e841018/MoDisp/photos/P_20190216_061420_vHDR_Auto.jpg

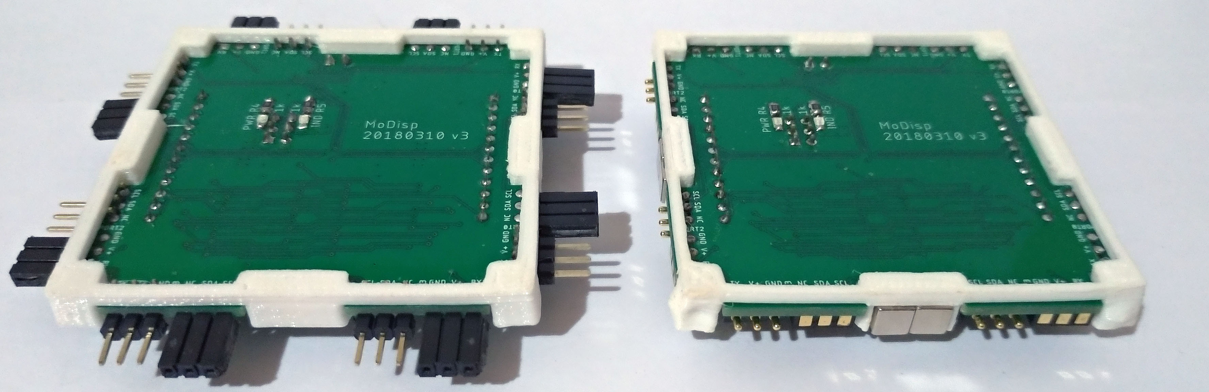
photos/P_20190216_061420_vHDR_Auto.jpg
