e841018/MoDisp/photos/P_20190216_060957_vHDR_Auto.jpg

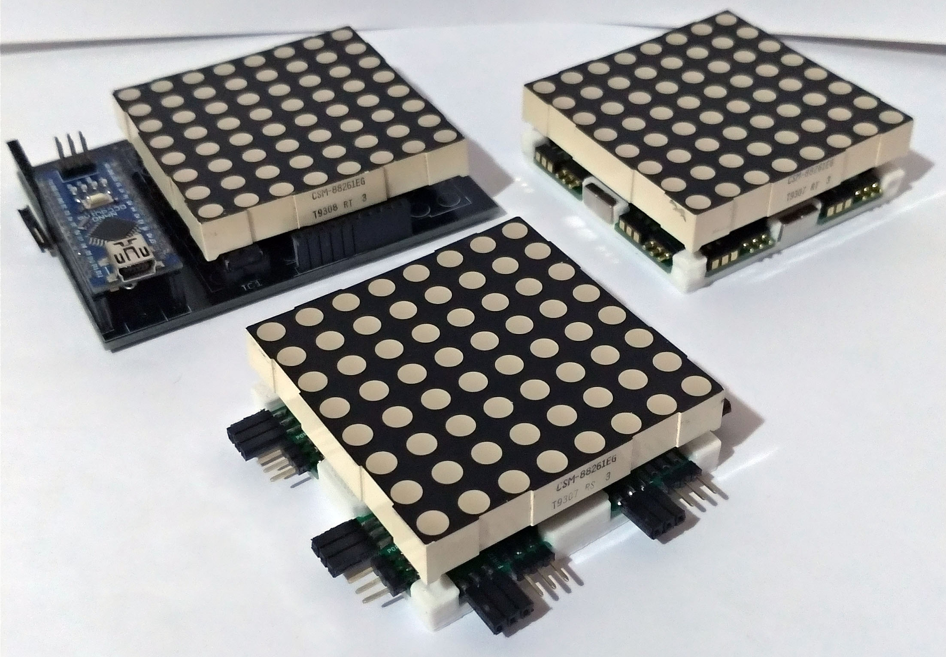
photos/P_20190216_060957_vHDR_Auto.jpg
