e841018/MoDisp/module/PCB/module.brd

## EAGLE design module/PCB/module.brd (2019-04-09)

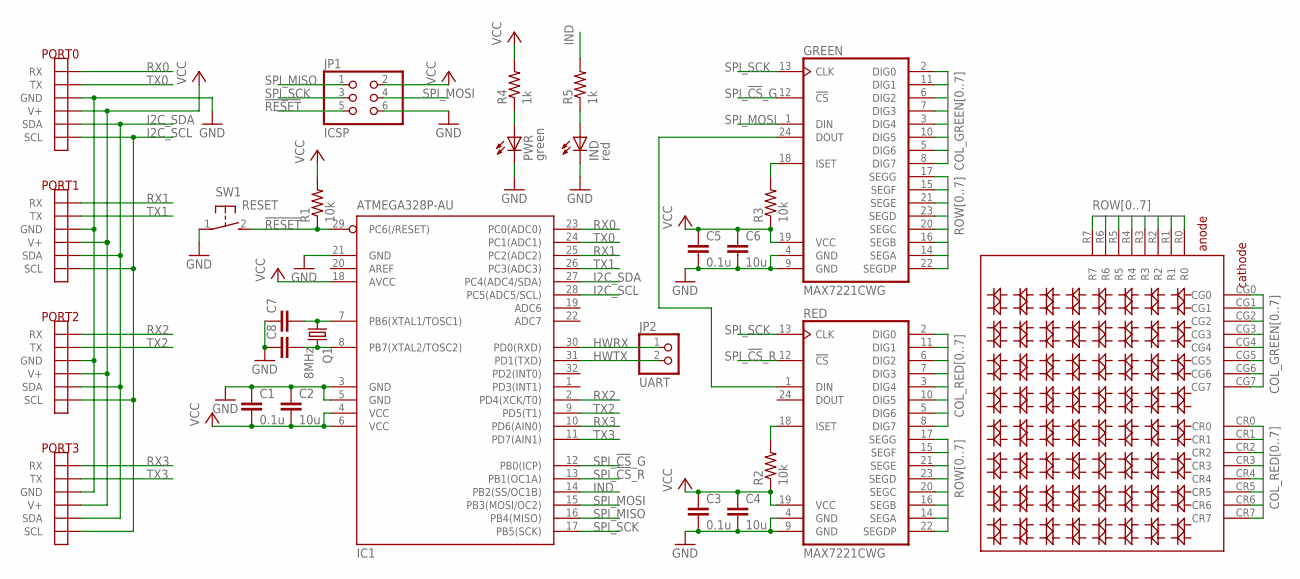
[picture p16: schematic module.sch]

Parts:
C1, C3, C5: 0.1u; C0805
C2, C4, C6: 10u; C1206
C7, C8: C-EUC0805; C0805
GREEN: MAX7221CWG; SO24L
IC1: ATMEGA328P-AU; TQFP32-08
IND: red; CHIPLED_0805
JP1: ICSP; 2X03
JP2: UART; 1X02
PORT0, PORT1, PORT2, PORT3: PORT
PWR: green; CHIPLED_0805
Q1: 8MHz; HC49UP
R1, R2, R3: 10k; R0805
R4, R5: 1k; R0805
RED: MAX7221CWG; SO24L
SW1: RESET; DTSM-3
U$2: 88LED_MATRIX_BICOLOR_ROW_ANODE; 8*8LED_MATRIX_BICOLOR_ROW_ANODE

Connections:
!RESET!: IC1.29 (PC6(/RESET)), JP1.5, R1.1, SW1.2
COL_GREEN0: GREEN.2 (DIG0), U$2.CG0
COL_GREEN1: GREEN.11 (DIG1), U$2.CG1
COL_GREEN2: GREEN.6 (DIG2), U$2.CG2
COL_GREEN3: GREEN.7 (DIG3), U$2.CG3
COL_GREEN4: GREEN.3 (DIG4), U$2.CG4
COL_GREEN5: GREEN.10 (DIG5), U$2.CG5
COL_GREEN6: GREEN.5 (DIG6), U$2.CG6
COL_GREEN7: GREEN.8 (DIG7), U$2.CG7
COL_RED0: RED.2 (DIG0), U$2.CR0
COL_RED1: RED.11 (DIG1), U$2.CR1
COL_RED2: RED.6 (DIG2), U$2.CR2
COL_RED3: RED.7 (DIG3), U$2.CR3
COL_RED4: RED.3 (DIG4), U$2.CR4
COL_RED5: RED.10 (DIG5), U$2.CR5
COL_RED6: RED.5 (DIG6), U$2.CR6
COL_RED7: RED.8 (DIG7), U$2.CR7
GND: C1.1, C2.1, C3.2, C4.2, C5.2, C6.2, C7.1, C8.1, GREEN.4 (GND), GREEN.9 (GND), IC1.3 (GND), IC1.5 (GND), IC1.21 (GND), IND.C, JP1.6, PORT0.GND_L (GND), PORT0.GND_L_D (GND), PORT0.GND_R (GND), PORT0.GND_R_D (GND), PORT1.GND_L (GND), PORT1.GND_L_D (GND), PORT1.GND_R (GND), PORT1.GND_R_D (GND), PORT2.GND_L (GND), PORT2.GND_L_D (GND), PORT2.GND_R (GND), PORT2.GND_R_D (GND), PORT3.GND_L (GND), PORT3.GND_L_D (GND), PORT3.GND_R (GND), PORT3.GND_R_D (GND), PWR.C, RED.4 (GND), RED.9 (GND), SW1.1
HWRX: IC1.30 (PD0(RXD)), JP2.1
HWTX: IC1.31 (PD1(TXD)), JP2.2
I2C_SCL: IC1.28 (PC5(ADC5/SCL)), PORT0.SCL_L (SCL), PORT0.SCL_L_D (SCL), PORT0.SCL_R (SCL), PORT0.SCL_R_D (SCL), PORT1.SCL_L (SCL), PORT1.SCL_L_D (SCL), PORT1.SCL_R (SCL), PORT1.SCL_R_D (SCL), PORT2.SCL_L (SCL), PORT2.SCL_L_D (SCL), PORT2.SCL_R (SCL), PORT2.SCL_R_D (SCL), PORT3.SCL_L (SCL), PORT3.SCL_L_D (SCL), PORT3.SCL_R (SCL), PORT3.SCL_R_D (SCL)
I2C_SDA: IC1.27 (PC4(ADC4/SDA)), PORT0.SDA_L (SDA), PORT0.SDA_L_D (SDA), PORT0.SDA_R (SDA), PORT0.SDA_R_D (SDA), PORT1.SDA_L (SDA), PORT1.SDA_L_D (SDA), PORT1.SDA_R (SDA), PORT1.SDA_R_D (SDA), PORT2.SDA_L (SDA), PORT2.SDA_L_D (SDA), PORT2.SDA_R (SDA), PORT2.SDA_R_D (SDA), PORT3.SDA_L (SDA), PORT3.SDA_L_D (SDA), PORT3.SDA_R (SDA), PORT3.SDA_R_D (SDA)
IND: IC1.14 (PB2(SS/OC1B)), R5.2
unnamed: C7.2, IC1.7 (PB6(XTAL1/TOSC1)), Q1.1
unnamed: C8.2, IC1.8 (PB7(XTAL2/TOSC2)), Q1.2
unnamed: GREEN.18 (ISET), R3.2
unnamed: GREEN.24 (DOUT), RED.1 (DIN)
unnamed: PWR.A, R4.1
unnamed: IND.A, R5.1
unnamed: R2.2, RED.18 (ISET)
ROW0: GREEN.17 (SEGG), RED.17 (SEGG), U$2.R0
ROW1: GREEN.15 (SEGF), RED.15 (SEGF), U$2.R1
ROW2: GREEN.21 (SEGE), RED.21 (SEGE), U$2.R2
ROW3: GREEN.23 (SEGD), RED.23 (SEGD), U$2.R3
ROW4: GREEN.20 (SEGC), RED.20 (SEGC), U$2.R4
ROW5: GREEN.16 (SEGB), RED.16 (SEGB), U$2.R5
ROW6: GREEN.14 (SEGA), RED.14 (SEGA), U$2.R6
ROW7: GREEN.22 (SEGDP), RED.22 (SEGDP), U$2.R7
RX0: IC1.23 (PC0(ADC0)), PORT0.RX_L (RX), PORT0.RX_L_D (RX)
RX1: IC1.25 (PC2(ADC2)), PORT1.RX_L (RX), PORT1.RX_L_D (RX)
RX2: IC1.2 (PD4(XCK/T0)), PORT2.RX_L (RX), PORT2.RX_L_D (RX)
RX3: IC1.10 (PD6(AIN0)), PORT3.RX_L (RX), PORT3.RX_L_D (RX)
SPI_!CS!_G: GREEN.12 (!CS!), IC1.12 (PB0(ICP))
SPI_!CS!_R: IC1.13 (PB1(OC1A)), RED.12 (!CS!)
SPI_MISO: IC1.16 (PB4(MISO)), JP1.1
SPI_MOSI: GREEN.1 (DIN), IC1.15 (PB3(MOSI/OC2)), JP1.4
SPI_SCK: GREEN.13 (CLK), IC1.17 (PB5(SCK)), JP1.3, RED.13 (CLK)
TX0: IC1.24 (PC1(ADC1)), PORT0.TX_R (TX), PORT0.TX_R_D (TX)
TX1: IC1.26 (PC3(ADC3)), PORT1.TX_R (TX), PORT1.TX_R_D (TX)
TX2: IC1.9 (PD5(T1)), PORT2.TX_R (TX), PORT2.TX_R_D (TX)
TX3: IC1.11 (PD7(AIN1)), PORT3.TX_R (TX), PORT3.TX_R_D (TX)
VCC: C1.2, C2.2, C3.1, C4.1, C5.1, C6.1, GREEN.19 (VCC), IC1.4 (VCC), IC1.6 (VCC), IC1.18 (AVCC), JP1.2, PORT0.V+_L (V+), PORT0.V+_L_D (V+), PORT0.V+_R (V+), PORT0.V+_R_D (V+), PORT1.V+_L (V+), PORT1.V+_L_D (V+), PORT1.V+_R (V+), PORT1.V+_R_D (V+), PORT2.V+_L (V+), PORT2.V+_L_D (V+), PORT2.V+_R (V+), PORT2.V+_R_D (V+), PORT3.V+_L (V+), PORT3.V+_L_D (V+), PORT3.V+_R (V+), PORT3.V+_R_D (V+), R1.2, R2.1, R3.1, R4.2, RED.19 (VCC)

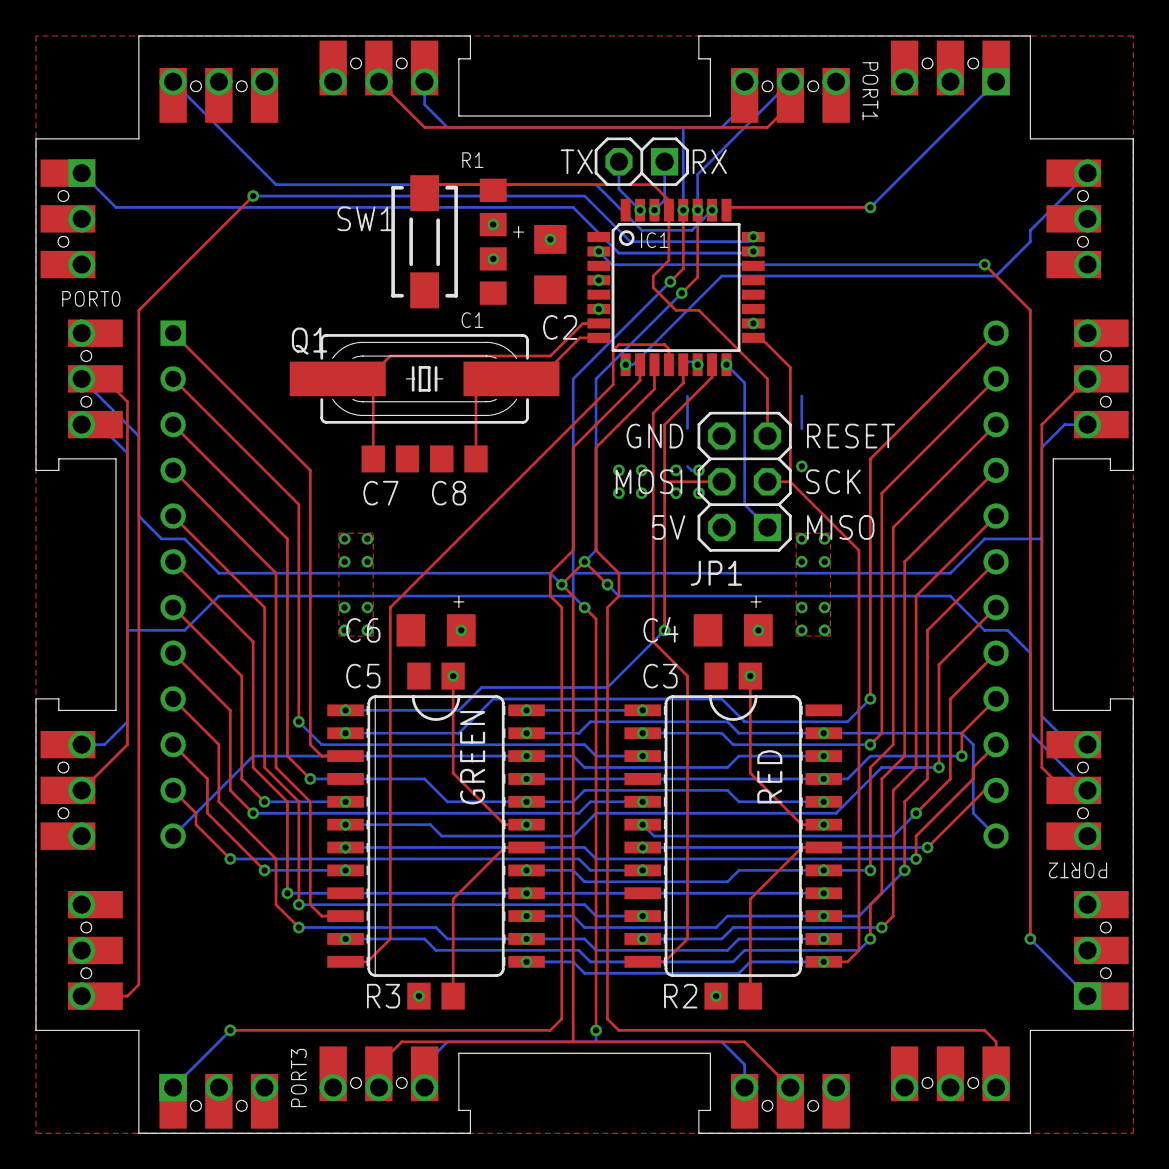
[picture p17: board module.brd from above]

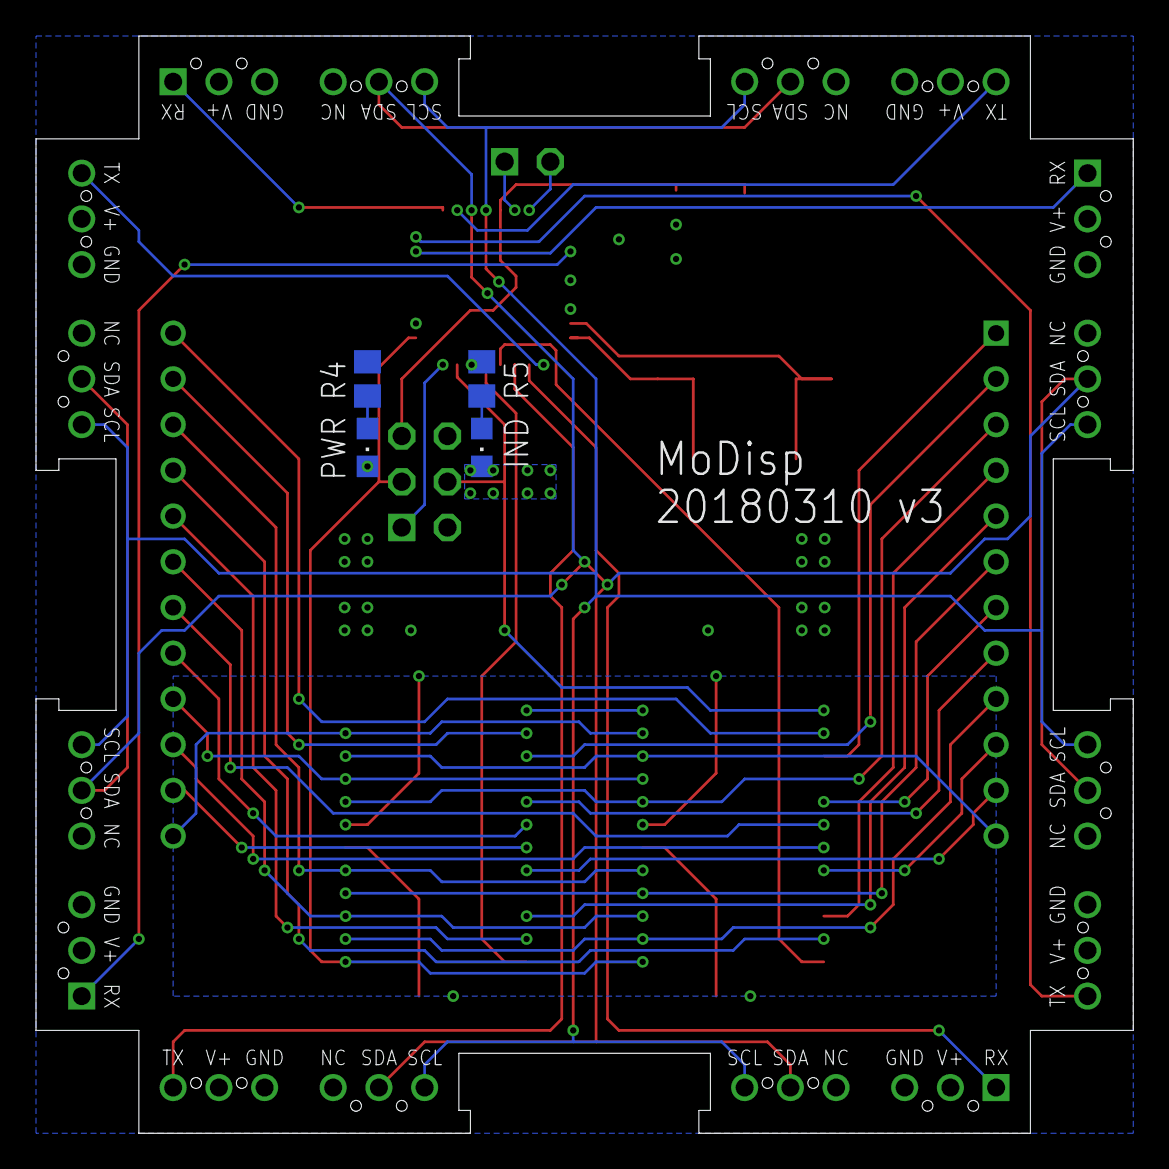
[picture p18: board module.brd from below]

Board: 2 copper layers, 61.0 x 61.0 mm, 27 parts (4 on the bottom side), 52 nets.
